PumaFPV/Component_lib/Mecha/PMK_Side_Conn_Spec.jpg

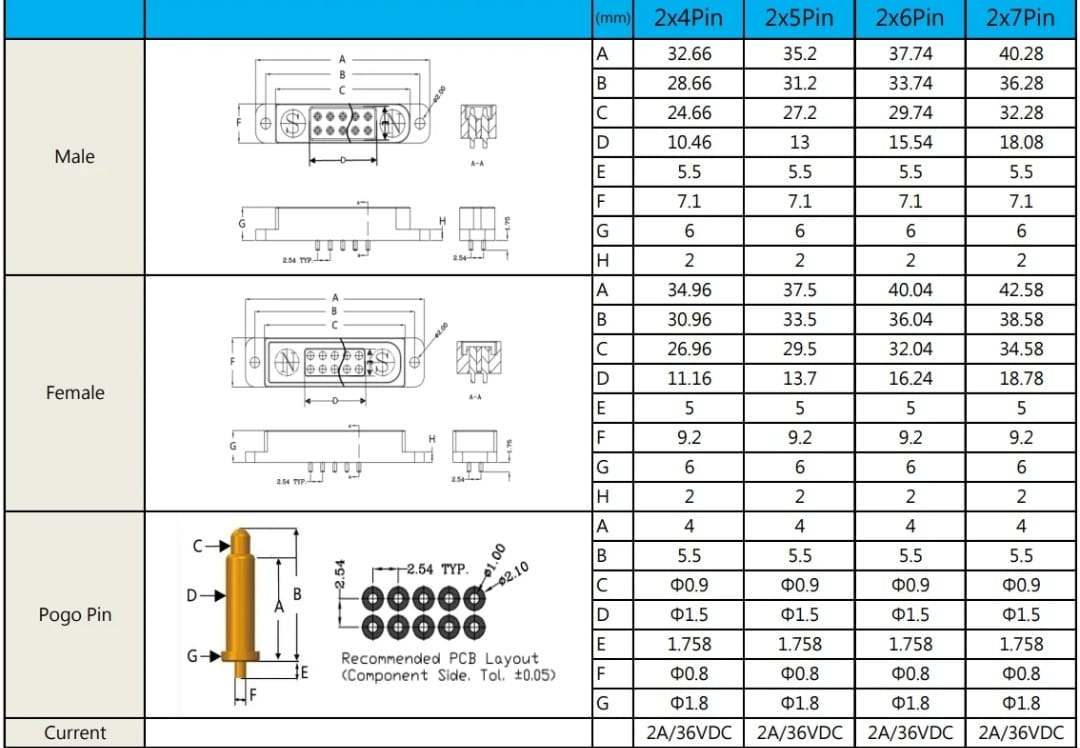
Mecha/PMK_Side_Conn_Spec.jpg
