PumaFPV/Component_lib/Mecha/Kailh Choc FunkMonk home.step

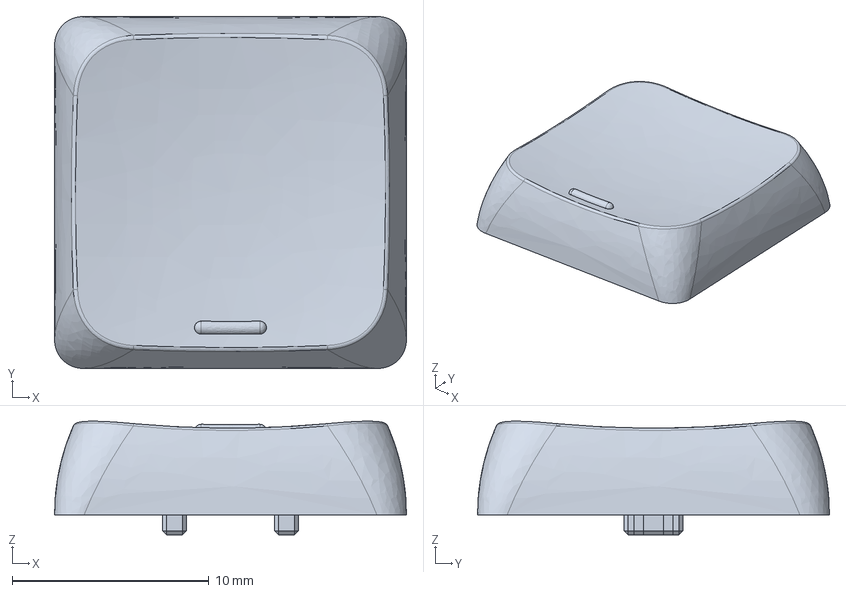
[picture p2: CAD file, 2023-05-31]
Mecha/Kailh Choc FunkMonk home.step
17.9 x 17.9 x 5.78 mm
