PumaFPV/Component_lib/Mecha/Kailh Choc Low Profile Switch.step

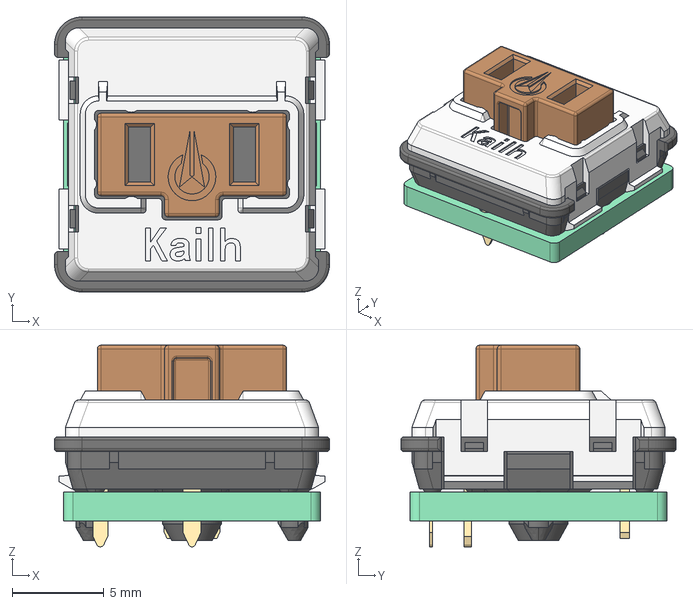
[picture p3: CAD file, 2023-05-31]
Mecha/Kailh Choc Low Profile Switch.step
15.0 x 15.0 x 11.0 mm
