PumaFPV/Component_lib/Mecha/Kailh Choc FunkMonk 1.5u.step

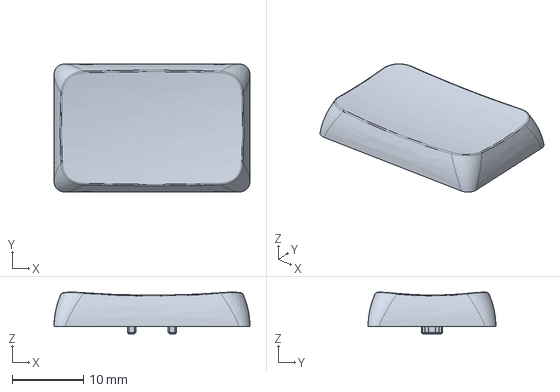
[picture p4: CAD file, 2023-05-31]
Mecha/Kailh Choc FunkMonk 1.5u.step
27.4 x 17.9 x 5.84 mm
