PumaFPV/Component_lib/(commit log)

2022-04-15 new file: Hardware/SamacSys_Parts.3dshapes/NCV8718BMT330TBG.stp new file: Hardware/SamacSys_Parts.pretty/SON65P200X200X80-7N.kicad_mod
2022-04-17 new file: Hardware/SamacSys_Parts.3dshapes/74LVC1G08GV,125.stp new file: Hardware/SamacSys_Parts.3dshapes/BGS12WN6E6327XTSA1.stp new file: Hardware/SamacSys_Parts.3dshapes/U.FL-R-SMT-1_40_.stp new fi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
2022-04-22 new file: Hardware/SamacSys_Parts.pretty/ER840S08SV5H.kicad_mod new file: Hardware/SamacSys_Parts.pretty/I-PEX_20533-040E.kicad_mod
2022-05-02 modified: Hardware/SamacSys_Parts.pretty/I-PEX_20533-040E.kicad_mod
2022-05-02 new file: Hardware/SamacSys_Parts.pretty/SM08B-SURS-TFLFSN.kicad_mod
2022-05-04 modified: Hardware/SamacSys_Parts.kicad_sym
2022-07-05 Added footprint for PiHAT
2022-07-10 Added ESP32-PICO-D4
2022-07-14 Updated CP2105 schematic
2022-07-16 Added some FPC connectors
2022-07-20 Added some power ICs
2022-07-20 Added some footprints
2022-07-28 Added motor and fan
2022-09-07 Fixed ESP32 schematic
2022-09-11 Updated ESP32 symbols
2022-10-06 Added ESP32S2FH4
2022-12-20 Added Kailh choc socket
2022-12-20 added ESP32C3
2023-01-16 moved esp gnd placement
2023-01-22 Added PCB USB connector
2023-02-01 Added led
2023-02-02 updated ESP32 ref des
2023-02-08 Added 2 USB C connectors
2023-05-17 added 3 connectors
2023-05-31 Added kailh step file
    [Kailh Choc FunkMonk 1.5u.step, Kailh Choc FunkMonk 1u.step, Kailh Choc FunkMonk home.step, Kailh Choc Low Profile Switch.step, Kailh LP Choc Burnt Orange.STEP]
2023-07-17 added connectors
2023-07-18 added 2 connectors
2023-10-05 added LiPo connectors
2023-10-30 added side switch
2024-01-18 Added psom connectors
2024-01-30 Changed contour to edge cut
2024-02-06 added PSoM ESP32S2 CB connector
2024-02-08 create PSoM ESP32S2 foootprint + 3D
2024-02-09 Added Cirque connector
2024-02-09 Added led, alltop, switch
2024-02-11 Added some ualside components and encoder
2024-02-13 Fixed DRC for kailh switch
2024-02-20 added mecha switch and pRadio components
2024-03-18 fixed psom that was updated for kicad 8
2024-03-23 added mounting hole for PSoM
2024-06-08 Added Aliexpress magnetic connector
2024-06-12 removed switch footprint
2024-06-16 added 12pins 0.5mm fpc connector
2024-08-18 added esp32s3pico and tp0.8mm
2024-08-27 fixed v2 kailh switch
2024-10-02 updated schematic part
2024-10-02 updated schematic
2024-10-11 added B3U-100P schematic part
2025-02-18 updated footprint links and datasheet
2025-02-18 updated datasheet and footprint
2025-02-18 changed footprint type
2025-03-02 added some symbols and footprints
2025-03-04 fix ufl footprint
2025-04-07 See description for complete list:
    Added connector: 2309413
    Added sensor: ADIS16470, ICM-45686, IIM-42686
    Added uC: STM32H753IIK6
2025-05-06 added DF36-15S-0.4V
2025-06-25 updated a footprint link
2025-10-06 synchronised capacitors with existing inventory database
2026-03-06 added esp32 s3 wroom, AP33771
2026-03-18 added text to esp32 s3
2026-05-18 added various connectors
